detective-owl/Marshal-Bot/Images/Rx Station .png

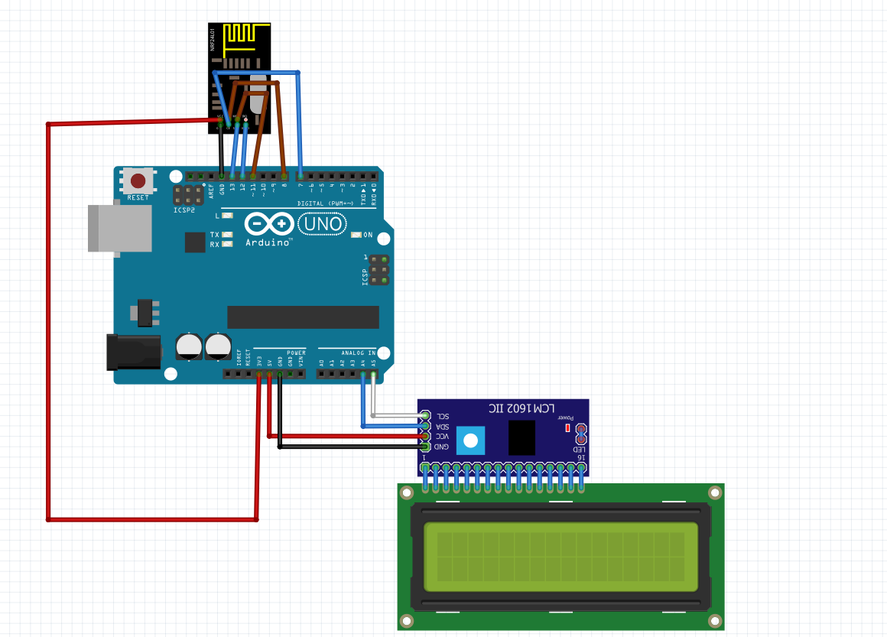
Images/Rx Station .png
