detective-owl/Marshal-Bot/Images/Tx Station .png

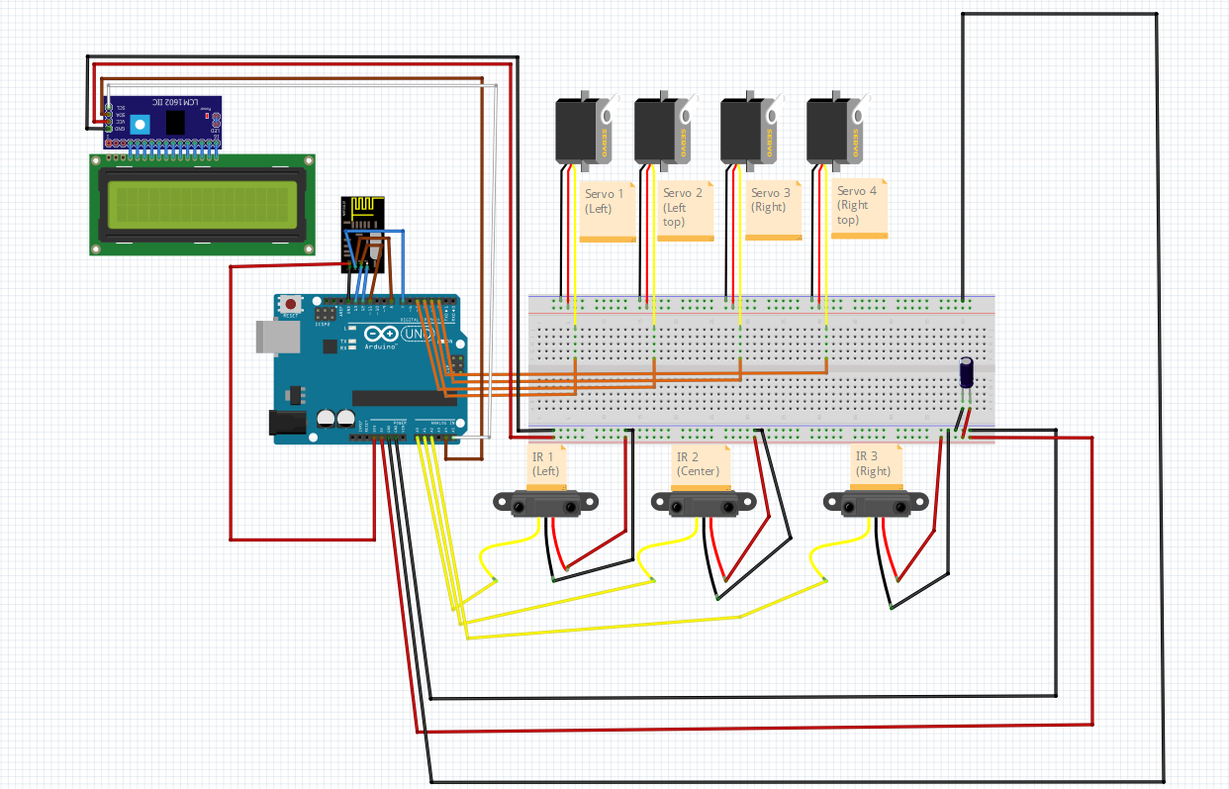
Images/Tx Station .png
