detective-owl/Marshal-Bot/(list of files, drawings)

Other design files:
Marshall Bot with Correct wiring.fzz
