detective-owl/Marshal-Bot/IF Statements measurements.xlsx

Marshalling Signals | Distance (Go Straight is Wrong) |  |  |  |  |  | Marshalling Signals | Distance (Go Straight is Wrong)
 | Left |  | Center |  | Right |  |  | Left |  | Center |  | Right
 | Minimum | Maximum | Minimum | Maximum | Minimum | Maximum |  | Minimum | Maximum | Minimum | Maximum | Minimum | Maximum
Face me | 44 | 56 | 102 | 130 | 84 | 128 | Face me
Go Straight | 51 | 39 | 19 | 126 | 134 | 119 | Go Straight
Go Left | 30 | 37 | 132 | 98 | 26 | 33 | Go Left
Go Right | 23 | 31 | 124 | 106 | 28 | 37 | Go Right
Slow Down | 46 | 40 | 23 | 42 | 128 | 130 | Slow Down
Stop | 53 | 49 | 19 | 22 | 99 | 104 | Stop
Marshalling Signals | Distance 2 (working)
 | Left |  | Center |  | Right
 | Minimum | Maximum | Minimum | Maximum | Minimum | Maximum
Face me | 77 | 93 | 65 | 132 | 45 | 55
Go Straight | 114 | 115 | 30 | 60 | 51 | 52
Go Left | 58 | 60 | 32 | 66 | 26 | 38
Go Right | 26 | 36 | 36 | 58 | 51 | 65
Slow Down | 108 | 115 | 25 | 28 | 42 | 49
Stop | 114 | 118 | 19 | 23 | 49 | 45
Marshalling Signals | Distance 3 (01/12/22)
 | Left |  | Center |  | Right
 | Minimum | Maximum | Minimum | Maximum | Minimum | Maximum
Face me | 77 | 93 | 65 | 132 | 45 | 55
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
