detective-owl/Marshal-Bot/(commit log)

2022-01-10 detective-owl modified marshall bot code
    Sharp IR sensor values issue and adding of NRF24L01 integration
2022-01-10 Description and Arduino Connections
2022-01-10 Rename Marshal_Final.ino to Marshal with Servo.ino
2022-01-13 Rename Marshal with Servo.ino to 1. Marshal with Servo.ino
2022-01-13 Rename Practice_Jedi.ino to 2. Marshall bot with Moving Servo.ino
2022-01-18 Rename calibration_part_4.ino to Calibrated Values.ino
